eChook/eChook-Nano-PCB/README.md

# eChook Nano PCB

This is the RS DesignSpark PCB project file and associated gerber files and BOM for the eChook Nano PCB v1.2

eChook Specific Libraries not included yet.

[Designspark 8 PCB](https://www.rs-online.com/designspark/pcb-software) required to view these files.
