eChook/eChook-Nano-PCB/KiKad/eChook_Nano/readme.md

V2.0a issues:
- Op Amp inputs switched. -FIXED 26/09
- TP Vias too small to capture multimeter probe tip. Fixed 26/09
- RPM inputs not working??
- No 24v power LED

V2.0b TODO
- Add 24v Indicator LED
- Make Throttle input 24v safe - 24mA through 200mA capable diode - TEST!
- THT Pads enlarged
- keep out zone around BT Mount point
- Totem Pole BAT54S diode protection on all inputs
-
