eChook/eChook-Nano-PCB/DesignSpark/eChookNano (PCB - Schematic and PCB Check Report).txt

Schematic and PCB Check Report
------------------------------

Report Written:     Friday, May 12, 2017
Project Path:       C:\Users\icooper\Downloads\ProjeChookNanoV1.1\eChookNano_v1.1\eChookNano.prj
Design Path:        C:\Users\icooper\Downloads\ProjeChookNanoV1.1\eChookNano_v1.1\eChookNano.pcb
Design Title:       
Created:            10/02/2017 12:29:38
Last Saved:         12/05/2017 08:46:07
Editing Time:       15531 min
Units:              mm (precision 2)

Checking integrity of Schematic and Pcb designs in project "eChookNano"
=======================================================================

End Of Report.
