eChook/eChook-Nano-PCB/KiKad/eChook_Nano/3D models/15EDGRC-3.81-03P-14-00AH.STEP

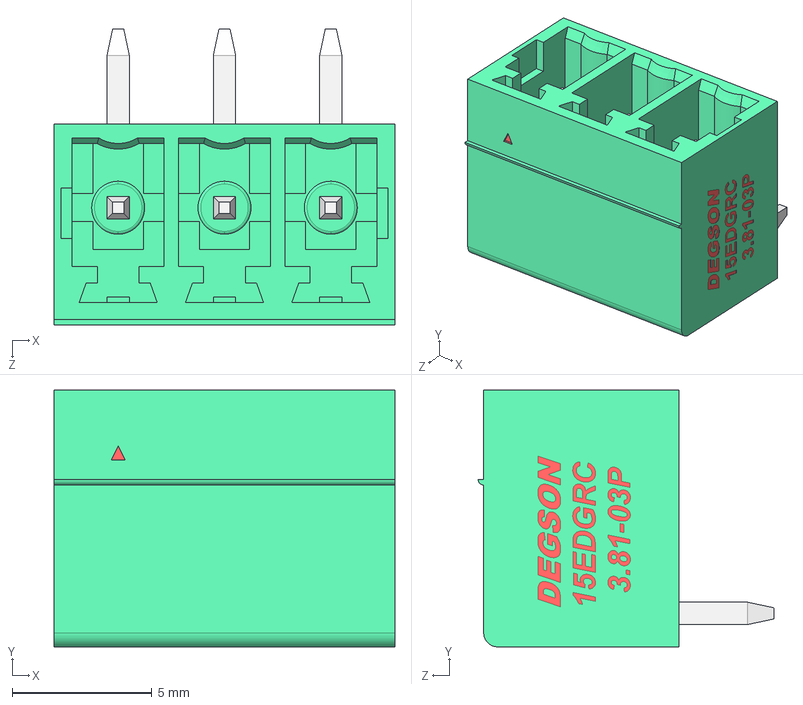
[picture p1: CAD file, 2022-01-12]
KiKad/eChook_Nano/3D models/15EDGRC-3.81-03P-14-00AH.STEP
12.2 x 9.20 x 10.6 mm
