eChook/eChook-Nano-PCB/KiKad/eChook_Nano/3D models/15EDGRC-5.08- 02P-14-00A(H).stp

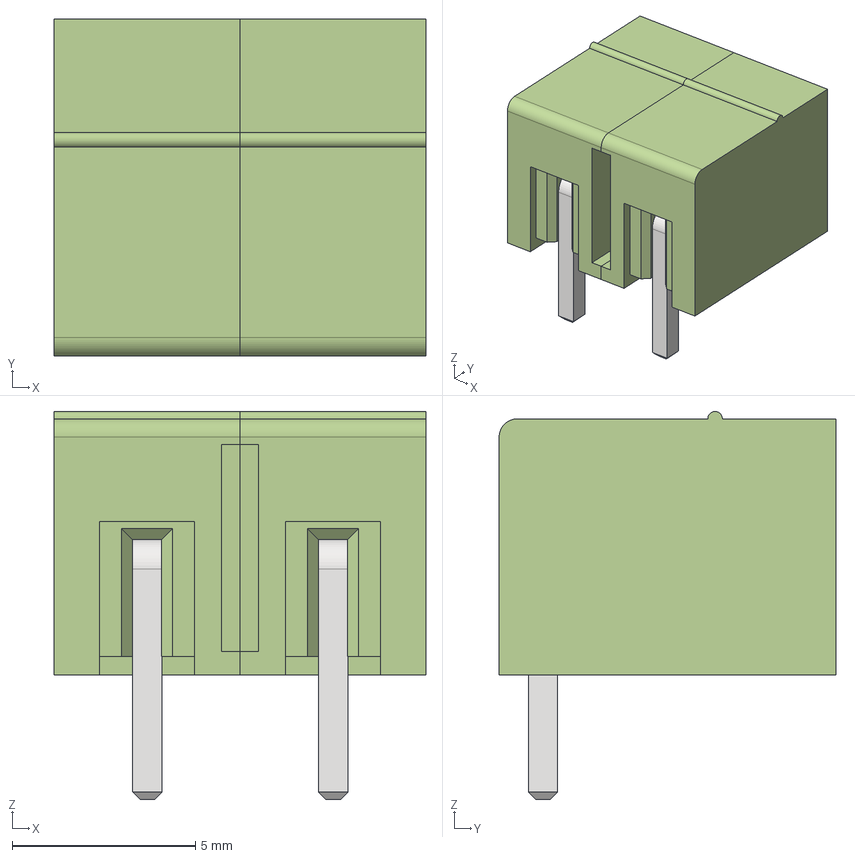
[picture p2: CAD file, 2022-01-12]
KiKad/eChook_Nano/3D models/15EDGRC-5.08- 02P-14-00A(H).stp
10.2 x 9.20 x 10.6 mm
body_1pc
contact x 2
body_1pc_1
