eChook/eChook-Nano-PCB/KiKad/eChook_Nano/3D models/Socket_DIP8.stp

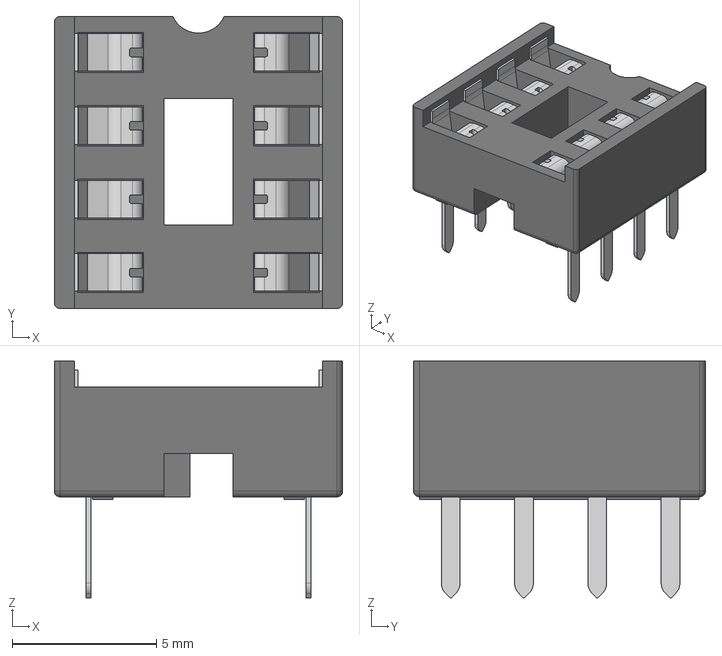
[picture p3: CAD file, 2022-01-12]
KiKad/eChook_Nano/3D models/Socket_DIP8.stp
10.0 x 10.1 x 8.20 mm
