eChook/eChook-Nano-PCB/KiKad/eChook_Nano/3D models/15EDGRC-5.08- 03P-14-00A(H).stp

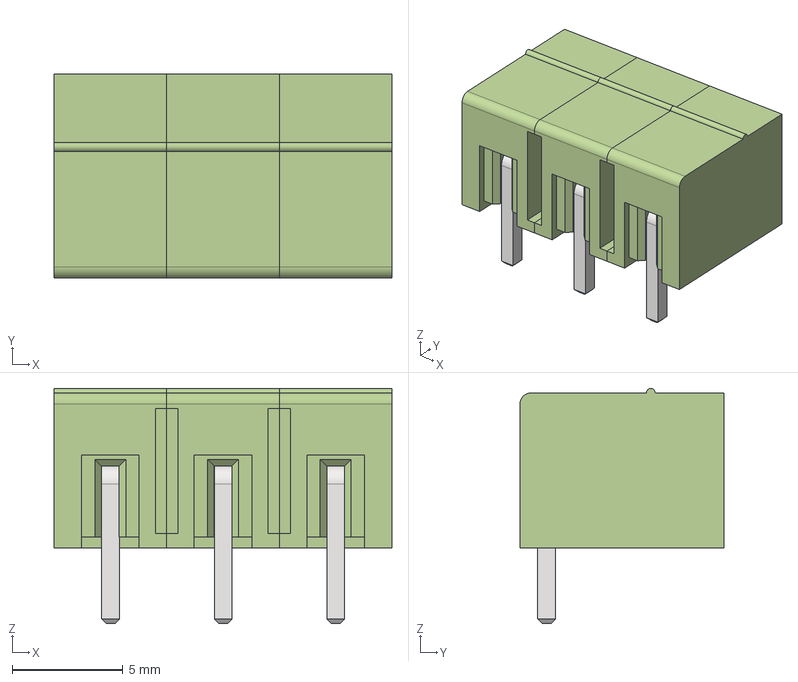
[picture p4: CAD file, 2022-01-12]
KiKad/eChook_Nano/3D models/15EDGRC-5.08- 03P-14-00A(H).stp
15.2 x 9.20 x 10.6 mm
body_1pc
contact x 3
body_1pc_1
body_1pc_2
