eChook/eChook-Nano-PCB/KiKad/eChook_Nano/3D models/arduino nano.stp

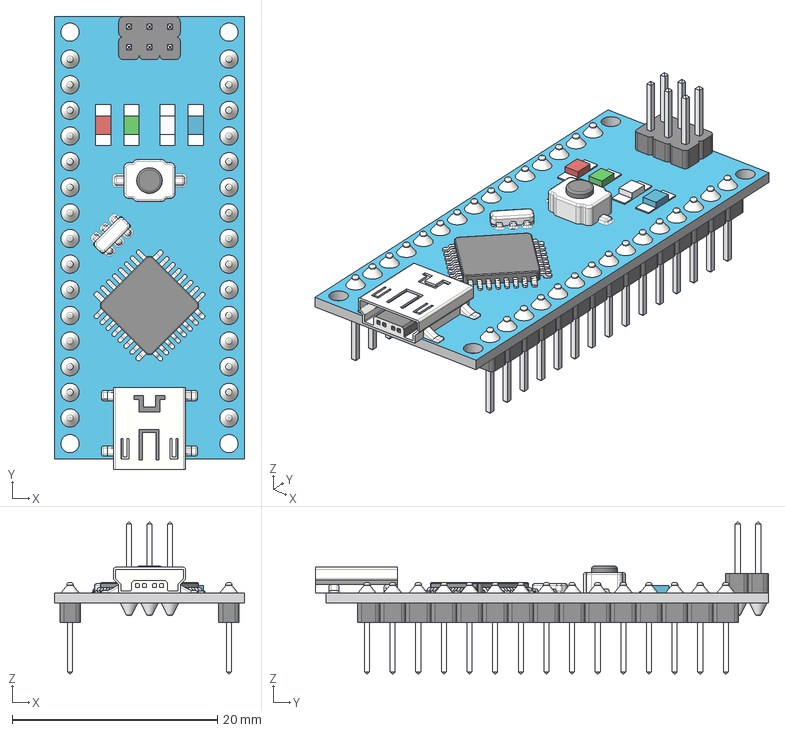
[picture p5: CAD file, 2022-01-12]
KiKad/eChook_Nano/3D models/arduino nano.stp
18.5 x 44.2 x 14.8 mm
