eChook/eChook-Nano-PCB/(list of files, drawings)

Other design files:
DesignSpark/eChookNano.pcb
DesignSpark/~eChookNano.pcb
