eChook/eChook-Nano-PCB/KiKad/eChook_Nano/eChook_Nano.kicad_pcb

## KiCad design KiKad/eChook_Nano/eChook_Nano.kicad_pcb (2025-12-13)

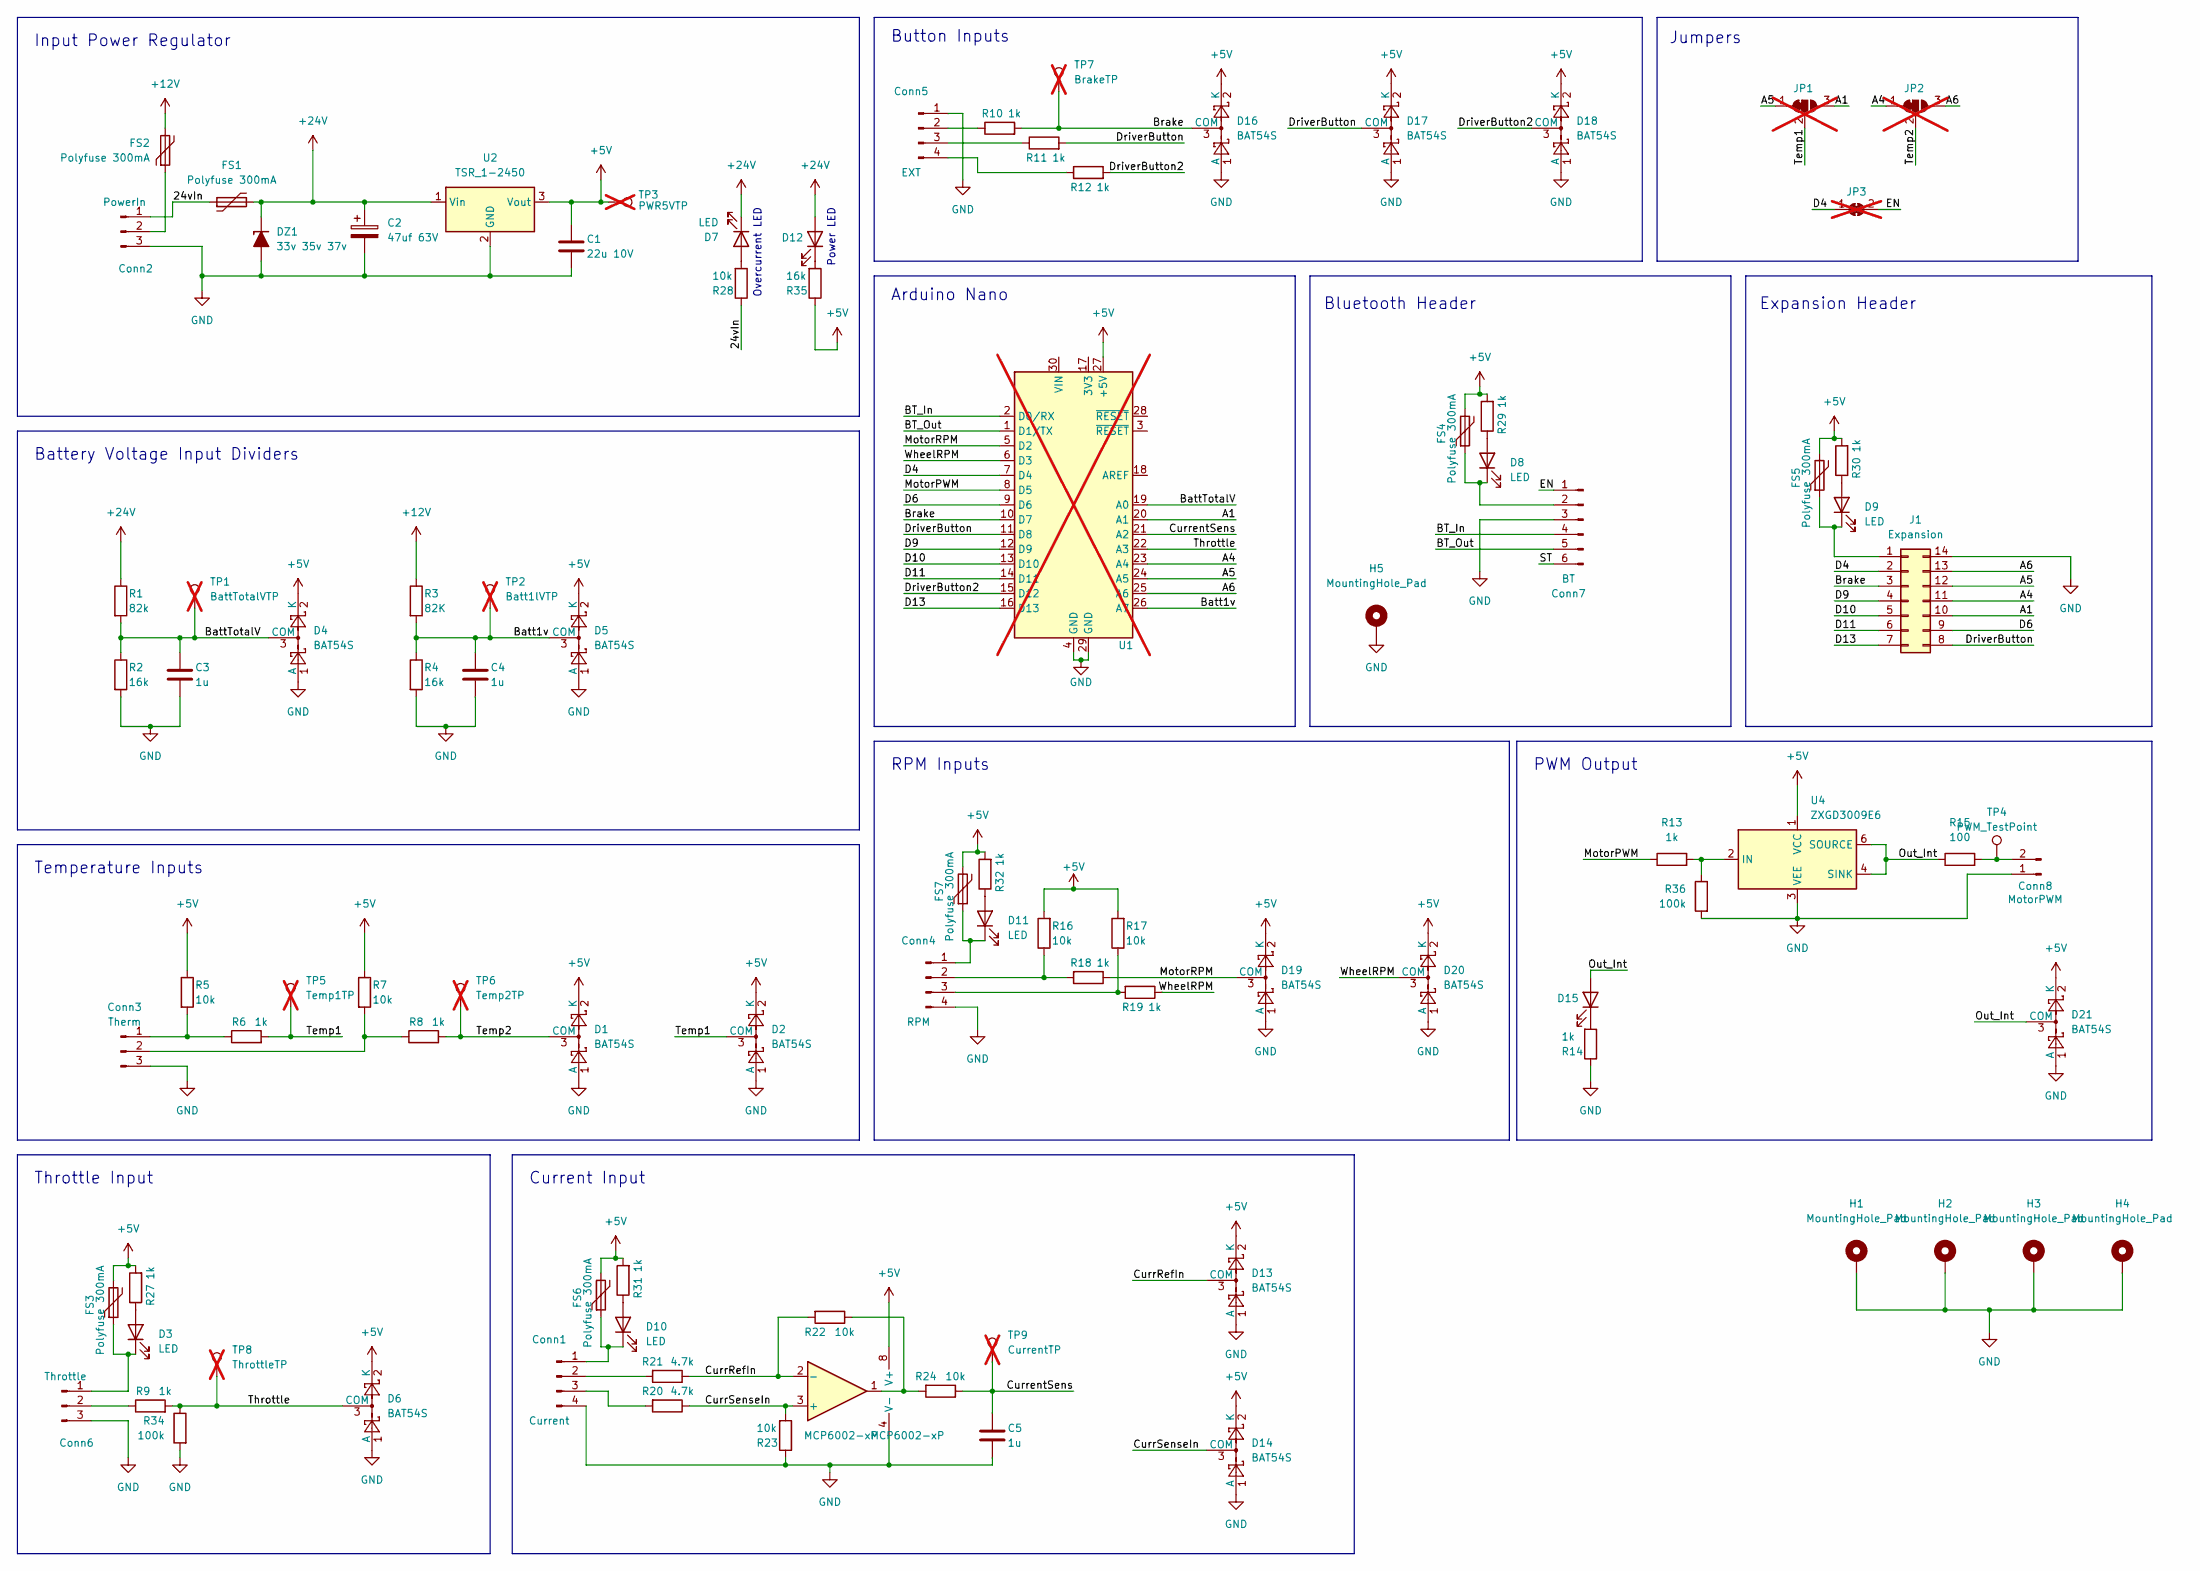
[picture p7: schematic eChook_Nano.kicad_sch, eChook Nano]

Parts:
C1: 22u 10V; C_0805_2012Metric; LCSC C45783
C2: 47uf 63V; CP_Elec_10x10; MPN EEEHA1J470P; LCSC C125977
C3, C4, C5: 1u; C_0805_2012Metric; LCSC C28323
Conn1: Current; Pluggable_Terminal_4_5.08mm; LCSC C8443
Conn2: PowerIn; Pluggable_Terminal_3_3.81mm; LCSC C8406
Conn3: Therm; Pluggable_Terminal_3_5.08mm; LCSC C70914
Conn4: RPM; Pluggable_Terminal_4_5.08mm; LCSC C8443
Conn5: EXT; Pluggable_Terminal_4_5.08mm; LCSC C8443
Conn6: Throttle; Pluggable_Terminal_3_5.08mm; LCSC C70914
Conn7: BT; PinHeader_1x06_P2.54mm_Vertical; LCSC C5224026
Conn8: MotorPWM; Pluggable_Terminal_2_5.08mm; LCSC C441204
D1, D2, D4, D5, D6, D13, D14, D16, D17, D18, D19, D20, D21: BAT54S; SOT-23; MPN BAT54S,215; LCSC C47546
D3, D7, D8, D9, D10, D11: LED; LED_0603_1608Metric; LCSC C2286
D12, D15: LED_GREEN; LED_0805_2012Metric; MPN KT-0805G; LCSC C2297
DZ1: 33v 35v 37v; D_SMB; MPN PTZTE2533B; LCSC C2909283
FS1, FS2, FS3, FS4, FS5, FS6, FS7: Polyfuse 300mA; Fuse_0603_1608Metric; MPN BHFUSE BSMD0603-010-36V; LCSC C7472522
H1, H2, H3, H4: MountingHole_Pad; MountingHole_3.2mm_M3_DIN965_Pad_TopBottom
H5: MountingHole_Pad; MountingHole_4.3mm_M4_DIN965_Pad
J1: Expansion; PinHeader_2x07_P2.54mm_Vertical; LCSC C38844
JP1, JP2: SolderJumper_3_Bridged12; SolderJumper-3_P1.3mm_Bridged12_RoundedPad1.0x1.5mm; not fitted
JP3: SolderJumper-2_P1.3mm_Bridged_RoundedPad1.0x1.5mm; not fitted
R1: 82k; R_0805_2012Metric; LCSC C21571501
R2, R4, R35: 16k; R_0805_2012Metric; LCSC C706220
R3: 82K; R_0805_2012Metric; LCSC C21571501
R5, R7, R16, R17, R22, R23, R24, R28: 10k; R_0805_2012Metric; LCSC C17414
R6, R8, R9, R10, R11, R12, R14, R18, R19, R27, R29, R30, R31, R32: 1k; R_0805_2012Metric; LCSC C17513
R13: 1k; R_0805_2012Metric; LCSC C17414
R15: 100; R_0805_2012Metric; LCSC C17414
R20, R21: 4.7k; R_0805_2012Metric; LCSC C17673
R34, R36: 100k; R_0805_2012Metric; LCSC C149504
TP1: BattTotalVTP; TestPoint_Pad_D3.0mm; not fitted
TP2: Batt1lVTP; TestPoint_Pad_D3.0mm; not fitted
TP3: PWR5VTP; TestPoint_Pad_D3.0mm; not fitted
TP4: PWM_TestPoint; TestPoint_Pad_D3.0mm
TP5: Temp1TP; TestPoint_Pad_D3.0mm; not fitted
TP6: Temp2TP; TestPoint_Pad_D3.0mm; not fitted
TP7: BrakeTP; TestPoint_Pad_D3.0mm; not fitted
TP8: ThrottleTP; TestPoint_Pad_D3.0mm; not fitted
TP9: CurrentTP; TestPoint_Pad_D3.0mm; not fitted
U1: Arduino_Nano_v3.x; Arduino_Nano; not fitted
U2: TSR_1-2450; Converter_DCDC_TRACO_TSR-1_THT; LCSC C19188491
U3: MCP6002-xP; SOIC-8_3.9x4.9mm_P1.27mm; LCSC C7377
U4: ZXGD3009E6; SOT-23-6; LCSC C156293

Connections:
+5V: C1.1, D1.2 (K), D2.2 (K), D4.2 (K), D5.2 (K), D6.2 (K), D13.2 (K), D14.2 (K), D16.2 (K), D17.2 (K), D18.2 (K), D19.2 (K), D20.2 (K), D21.2 (K), FS3.2, FS4.2, FS5.2, FS6.2, FS7.2, R5.1, R7.1, R16.2, R17.2, R27.2, R29.2, R30.2, R31.2, R32.2, R35.1, TP3.1, U1.27 (+5V), U2.3 (Vout), U3.8 (V+), U4.1 (VCC)
+12V: FS2.2, R3.1
+24V: C2.1, D7.1 (K), D12.2 (A), DZ1.1 (K), FS1.2, R1.1, U2.1 (Vin)
/24vIn: Conn2.1, FS1.1, R28.1
/A1: J1.10, JP1.3 (B), U1.20 (A1)
/A4: J1.11, JP2.1 (A), U1.23 (A4)
/A5: J1.12, JP1.1 (A), U1.24 (A5)
/A6: J1.13, JP2.3 (B), U1.25 (A6)
/BT_In: Conn7.4, U1.2 (D0/RX)
/BT_Out: Conn7.5, U1.1 (D1/TX)
/Batt1v: C4.1, D5.3 (COM), R3.2, R4.1, TP2.1, U1.26 (A7)
/BattTotalV: C3.1, D4.3 (COM), R1.2, R2.1, TP1.1, U1.19 (A0)
/Brake: D16.3 (COM), J1.3, R10.2, TP7.1, U1.10 (D7)
/CurrRefIn: D13.3 (COM), R21.1, R22.2, U3.2 (-)
/CurrSenseIn: D14.3 (COM), R20.1, R23.2, U3.3 (+)
/CurrentSens: C5.1, R24.1, TP9.1, U1.21 (A2)
/D4: J1.2, JP3.1 (A), U1.7 (D4)
/D6: J1.9, U1.9 (D6)
/D9: J1.4, U1.12 (D9)
/D10: J1.5, U1.13 (D10)
/D11: J1.6, U1.14 (D11)
/D13: J1.7, U1.16 (D13)
/DriverButton: D17.3 (COM), J1.8, R11.2, U1.11 (D8)
/DriverButton2: D18.3 (COM), R12.2, U1.15 (D12)
/EN: Conn7.1, JP3.2 (B)
/MotorPWM: R13.1, U1.8 (D5)
/MotorRPM: D19.3 (COM), R18.1, U1.5 (D2)
/Out_Int: D15.2 (A), D21.3 (COM), R15.1, U4.4 (SINK), U4.6 (SOURCE)
/ST: Conn7.6
/Temp1: D2.3 (COM), JP1.2 (C), R6.2, TP5.1
/Temp2: D1.3 (COM), JP2.2 (C), R8.2, TP6.1
/Throttle: D6.3 (COM), R9.2, R34.1, TP8.1, U1.22 (A3)
/WheelRPM: D20.3 (COM), R19.1, U1.6 (D3)
GND: C1.2, C2.2, C3.2, C4.2, C5.2, Conn1.4, Conn2.3, Conn3.3, Conn4.4, Conn5.1, Conn6.3, Conn7.3, Conn8.1, D1.1 (A), D2.1 (A), D4.1 (A), D5.1 (A), D6.1 (A), D13.1 (A), D14.1 (A), D16.1 (A), D17.1 (A), D18.1 (A), D19.1 (A), D20.1 (A), D21.1 (A), DZ1.2 (A), H1.1, H2.1, H3.1, H4.1, H5.1, J1.14, R2.2, R4.2, R14.1, R23.1, R34.2, R36.2, U1.4 (GND), U1.29 (GND), U2.2 (GND), U3.4 (V-), U4.3 (VEE)
unnamed: Conn1.1, D10.1 (K), FS6.1
unnamed: Conn1.2, R21.2
unnamed: Conn1.3, R20.2
unnamed: Conn2.2, FS2.1
unnamed: Conn3.1, R5.2, R6.1
unnamed: Conn3.2, R7.2, R8.1
unnamed: Conn4.1, D11.1 (K), FS7.1
unnamed: Conn4.2, R16.1, R18.2
unnamed: Conn4.3, R17.1, R19.2
unnamed: Conn5.2, R10.1
unnamed: Conn5.3, R11.1
unnamed: Conn5.4, R12.1
unnamed: Conn6.1, D3.1 (K), FS3.1
unnamed: Conn6.2, R9.1
unnamed: Conn7.2, D8.1 (K), FS4.1
unnamed: Conn8.2, R15.2, TP4.1
unnamed: D3.2 (A), R27.1
unnamed: D7.2 (A), R28.2
unnamed: D8.2 (A), R29.1
unnamed: D9.2 (A), R30.1
unnamed: D9.1 (K), FS5.1, J1.1
unnamed: D10.2 (A), R31.1
unnamed: D11.2 (A), R32.1
unnamed: D12.1 (K), R35.2
unnamed: D15.1 (K), R14.2
unnamed: R22.1, R24.2, U3.1
unnamed: R13.2, R36.1, U4.2 (IN)

Notes on the sheet:
Bluetooth Header
Input Power Regulator
Throttle Input
RPM Inputs
Arduino Nano
PWM Output
Power LED
Temperature Inputs
Current Input
Button Inputs
Overcurrent LED
Expansion Header
Jumpers
Battery Voltage Input Dividers

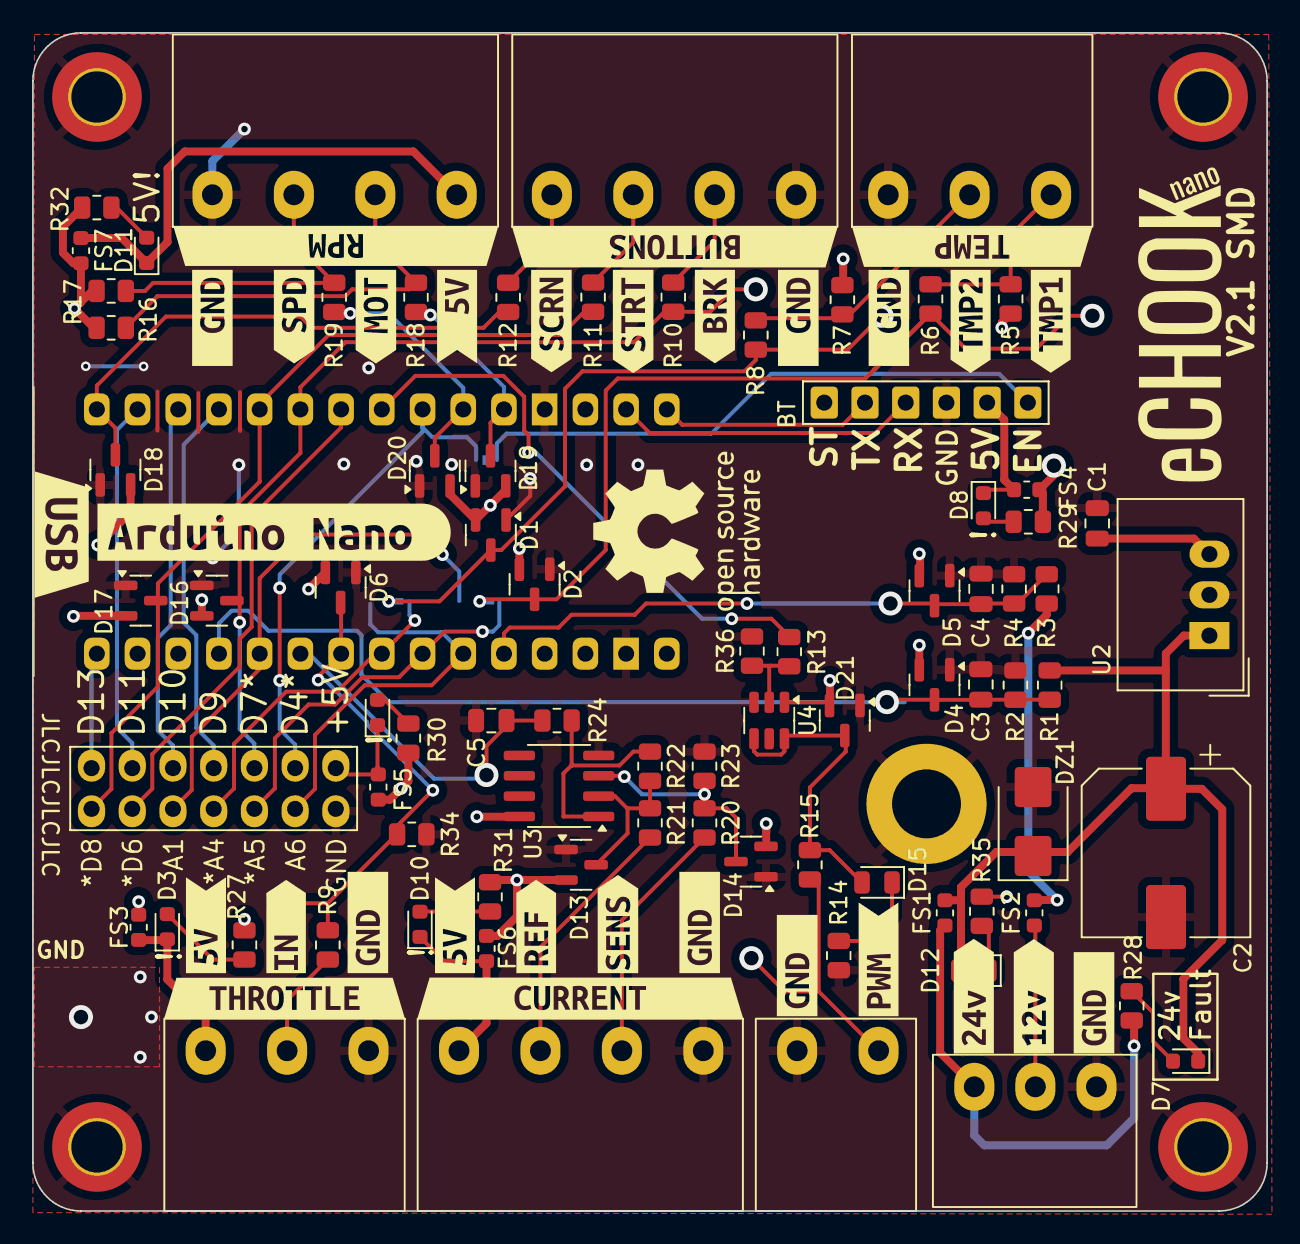
[picture p8: board eChook_Nano.kicad_pcb from above]

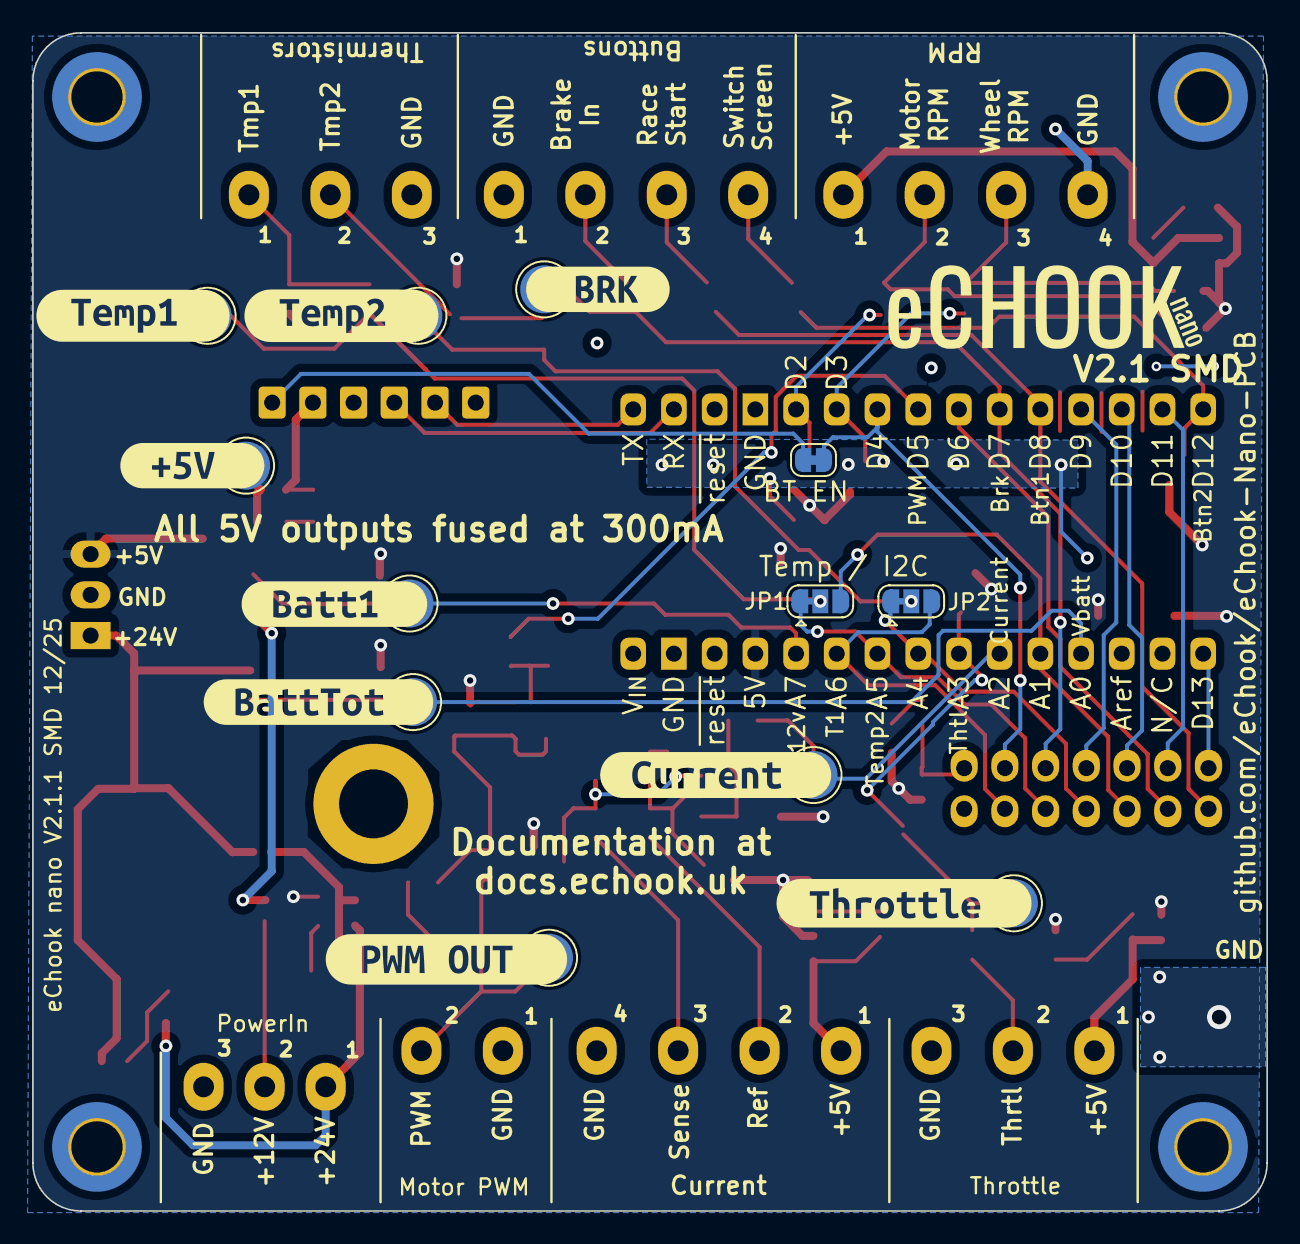
[picture p9: board eChook_Nano.kicad_pcb from below]

Board: 2 copper layers, 77.0 x 73.5 mm, 138 parts (21 on the bottom side), 60 nets.

Other parts of the board:
BC1, BC2: BOM-Component
kibuzzard-66D71FF8: G***; kibuzzard-66D71FF8
kibuzzard-66D72A35: G***; kibuzzard-66D72A35
kibuzzard-66D86D8A: G***; kibuzzard-66D86D8A
kibuzzard-66D86D91: G***; kibuzzard-66D86D91
kibuzzard-66D86E8F: G***; kibuzzard-66D86E8F
kibuzzard-66D86EA3: G***; kibuzzard-66D86EA3
kibuzzard-66D86EBA: G***; kibuzzard-66D86EBA
kibuzzard-66D86EDC: G***; kibuzzard-66D86EDC
kibuzzard-66D86F00: G***; kibuzzard-66D86F00
kibuzzard-66D86F2B: G***; kibuzzard-66D86F2B
kibuzzard-66D86F7C: G***; kibuzzard-66D86F7C
kibuzzard-66D86F40: G***; kibuzzard-66D86F40
kibuzzard-66D86F46: G***; kibuzzard-66D86F46
kibuzzard-66D86F51: G***; kibuzzard-66D86F51
kibuzzard-66D86F60: G***; kibuzzard-66D86F60
kibuzzard-66D727FC: G***; kibuzzard-66D727FC
kibuzzard-66D728C6: G***; kibuzzard-66D728C6
kibuzzard-66D728F7: G***; kibuzzard-66D728F7
kibuzzard-66D7200F: G***; kibuzzard-66D7200F
kibuzzard-66D7283F: G***; kibuzzard-66D7283F
kibuzzard-66D72019, kibuzzard-66D72019#2, kibuzzard-66D72019#3, kibuzzard-66D72019#4: G***; kibuzzard-66D72019
kibuzzard-66D72322: G***; kibuzzard-66D72322
kibuzzard-66D72613, kibuzzard-66D72613#2: G***; kibuzzard-66D72613
kibuzzard-66D72997: G***; kibuzzard-66D72997
kibuzzard-66E1D05B: G***; kibuzzard-66E1D05B
kibuzzard-66E1D172: G***; kibuzzard-66E1D172
kibuzzard-66E1DBD4: G***; kibuzzard-66E1DBD4
kibuzzard-66E1DC01: G***; kibuzzard-66E1DC01
kibuzzard-66E1DD3E: G***; kibuzzard-66E1DD3E
kibuzzard-66E1DD07: G***; kibuzzard-66E1DD07
kibuzzard-66E1DD26: G***; kibuzzard-66E1DD26
kibuzzard-66E1DDEC: G***; kibuzzard-66E1DDEC
kibuzzard-66E1DE80: G***; kibuzzard-66E1DE80
kibuzzard-66E1DE99: G***; kibuzzard-66E1DE99
kibuzzard-67D9A076: G***; kibuzzard-67D9A076
