eChook/eChook-Nano-PCB/(threads)

Thread 1 (2024-10-16):

Arduino getting fried

peteallenm, 2024-10-16:
Thank you for all your work on eChook - it is a really helpful platform.

We have had an issue twice now where the arduino has got fried - it stops responding, draws a load of power and gets burning hot (as does the 3.3V regulator.)

I enlisted a friend who has a lot of motorsport and automotive electronics experience, and he said:

From experience, when microcontrollers get very hot, it's often because an I/O pin has been driven beyond its supply/ground rails (even briefly during a noise spike, or when the micro is unpowered) and/or too much current has been injected into the pin (insufficient series resistance). This causes the pin's internal circuit to "latch up", which causes a lot of current to flow internally to the micro - it basically causes a shoot-through from the +ve supply to ground.
For gory details about "latch up", this is quite good:
https://www.ti.com/lit/wp/scaa124/scaa124.pdf

Here's a marked-up schematic to show how I might improve it if I was putting it onto a car:

I've attached his suggestions for if you want to tweak future versions.
[Suggest improvements.pdf](https://github.com/user-attachments/files/17403143/Suggest.improvements.pdf)

GryphonR, 2024-10-17:
Hi Pete,

Thank you for the feedback - and your friend for his efforts with the schematic. I'm sorry about your fried arduinos! (I think this happens more frequently than I'm aware of, as teams don't often tell me)

I completely agree with his diagnostics - and his solutions. Your timing is actually spot on, if you take a look in the 'smd' branch of this repository you'll find an updated schematic with a lot more protection built in. Along very similar lines to the suggested improvements above. He's making me wonder if I should have increased some of the resistance values some more though! These are V2.0 of the board, and should be in stock with Greenpower in the next month or so.

There are a few reasons the original board is as it is - ranging from our lack of electronics experience at the time of design, to keeping the component count as low as possible to make the assembly process easier, and to limiting the circuits to those covered by the GCSE and A Level Electronics curriculum. The V2.0 does away with most of these limitations - it will be sold assembled, has a far higher component count, isn't limited to the curriculum, and I like to think I've learnt a bit more over the last few years :)

Hopefully this one will evolve slightly faster than the V1.x, and I'll have a play with adding some of the suggested improvements that I've missed this time in future versions.

V2 Schematic:
[eChook Nano v2.0 SMD Schematic](https://github.com/user-attachments/files/17408025/eChook_Nano.pdf)

peteallenm, 2024-10-19:
That's really good to hear, and the v2.0 looks a really good upgrade. We are looking forward to it!
