eChook/eChook-Nano-PCB/(commit log)

2017-06-07 initial commit of V1.1
    [eChookNano - Board Outlline.gbr, eChookNano - Bottom Copper (Resist).gbs, eChookNano - Bottom Copper.gbl, eChookNano - Bottom Silkscreen.gbo, eChookNano - Top Copper (Resist).gts, eChookNano - Top Copper.gtl, eChookNano - Top Silkscreen.gto]
2017-06-08 Added BOM
    [eChookNano (Bill Of Materials).csv, eChookNano.pcb, eChookNano.sch]
2017-07-06 Updated to latest PCB design
    [eChookNano.pcb, eChookNano.sch]
2017-07-28 V1.2 - improved solder mask tolerances, added test points and silkscreen logo
    [eChookNano.pcb, eChookNano.sch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]
2017-08-23 Updated PCB Version in Readme
2022-01-04 Restructured Filesystem. Started KiCad Recreation
    [eChookNano (Bill Of Materials).csv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]
2022-01-04 Add KiCad gitignore
2022-01-10 Finished PCB Replication, added iBOM
    [eChook_Nano.kicad_pcb, eChook_Nano.kicad_sch, ~eChookNano.pcb, ~eChookNano.sch]
2022-01-12 Added 3D models and layout/silkscreen improvements
    [eChook_Nano.kicad_pcb, eChook_Nano.kicad_sch]
2022-01-12 Added 3D models
    [15EDGRC-3.81-03P-14-00AH.STEP, 15EDGRC-5.08- 02P-14-00A(H).stp, 15EDGRC-5.08- 03P-14-00A(H).stp, 15EDGRC-5.08- 04P-14-00A(H).stp, Socket_DIP8.stp, arduino nano.stp]
2022-01-15 Fixed Silkscreen Current Conn Pin Out
    [eChook_Nano.kicad_pcb]
2022-02-14 Updated ext. pin out
    [eChook_Nano.kicad_pcb, eChook_Nano.kicad_sch]
2022-03-14 R15 and R24 Value Correction, new IBOM
    [eChook_Nano.kicad_pcb, eChook_Nano.kicad_sch]
2024-09-03 SMD Conversion
    [eChook_Nano.kicad_pcb, eChook_Nano.kicad_sch]
2024-09-04 Routing Complete
    [eChook_Nano.kicad_pcb, eChook_Nano.kicad_sch]
2024-09-04 connector Labels corrected
    [eChook_Nano.kicad_pcb]
2024-09-11 Added ground plane under nano
    [eChook_Nano.kicad_pcb]
2024-09-11 production ready
    [eChook_Nano.kicad_sch]
2024-09-12 Marked Alpha board, improved rotations
2024-09-26 Fixing V2.0a issues
    [eChook_Nano.kicad_sch]
2024-09-30 Updated to BAT54S diodes. Added protection on all inputs
    [eChook_Nano.kicad_sch]
2024-10-01 Layout and Silkscreen tweaks
2024-10-01 Reduced BT Support Hole to 3.2mm
2024-10-02 Back to M4 Mount for BT Support
2024-12-17 Added gerbers for V1.3
2025-03-18 Updated Resistor values for PWM Out
2025-03-18 Added gate driver PWM output stage
    [eChook_Nano.kicad_sch]
2025-03-20 Increased PWR LED Resistance, Added mounting holes to SCH
    [eChook_Nano.kicad_sch]
2025-03-20 Fixed Mounting hole positions
    [eChook_Nano.kicad_pcb]
2025-12-13 24v LED fixed. Improved Routing and Labels
